rsc-dev/IAQ-MK2/iaq-mk2/src/ArduinoJson/README.md

# ArduinoJson (vendored)

Single-header release v7.4.3 of https://arduinojson.org (MIT, Benoit Blanchon),
unmodified. Vendored so the firmware and the host tests parse with the same
copy; no Library Manager dependency.
