rsc-dev/IAQ-MK2/docs/images/layouts/layout_A_current_bad.png

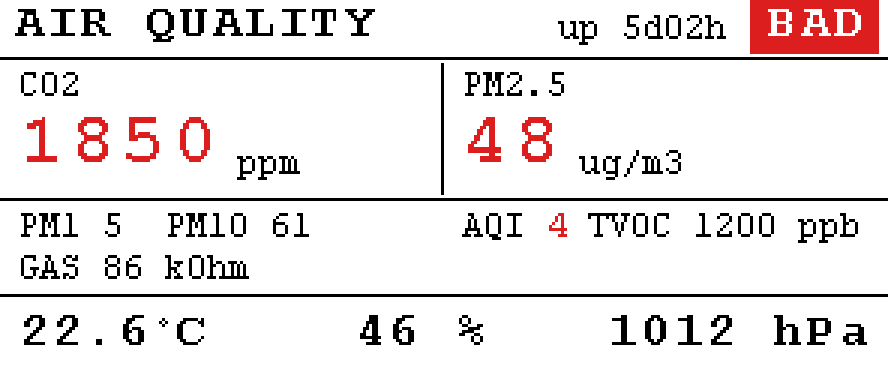
docs/images/layouts/layout_A_current_bad.png
