rsc-dev/IAQ-MK2/docs/images/layouts/layout_A_current_good.png

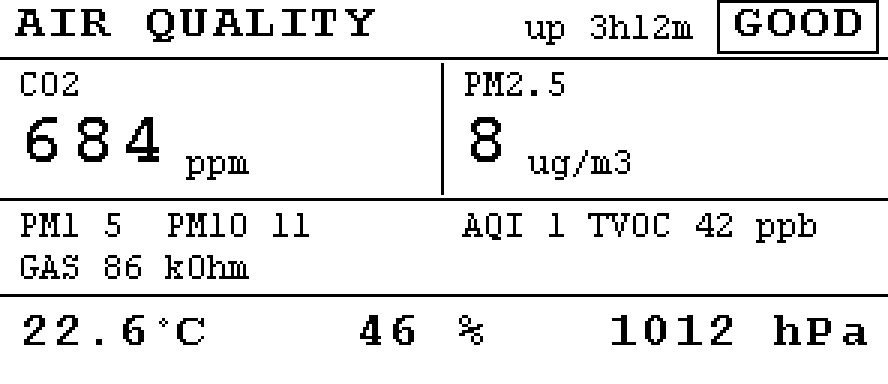
docs/images/layouts/layout_A_current_good.png
