rsc-dev/IAQ-MK2/docs/images/layouts/layout_B_three_tiles_good.png

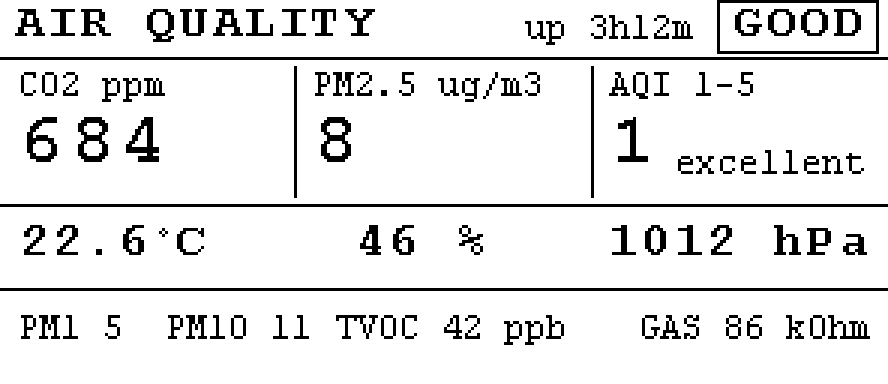
docs/images/layouts/layout_B_three_tiles_good.png
