rsc-dev/IAQ-MK2/docs/images/layouts/layout_C_status_board_bad.png

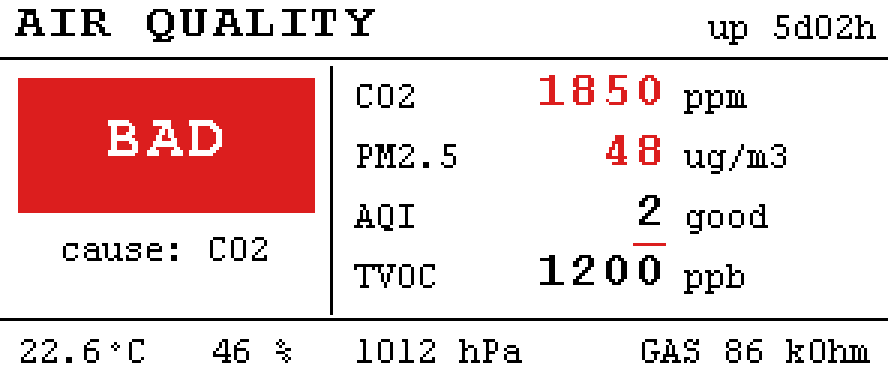
docs/images/layouts/layout_C_status_board_bad.png
