rsc-dev/IAQ-MK2/docs/images/layouts/layout_C_status_board_good.png

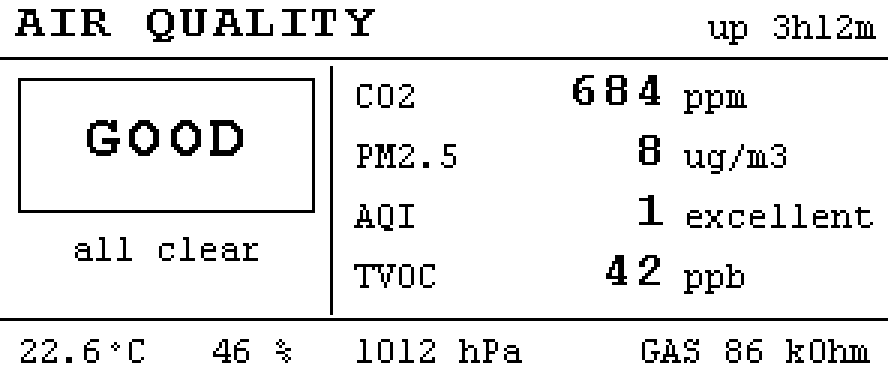
docs/images/layouts/layout_C_status_board_good.png
