rsc-dev/IAQ-MK2/docs/images/layouts/layout_D_climate_first_good.png

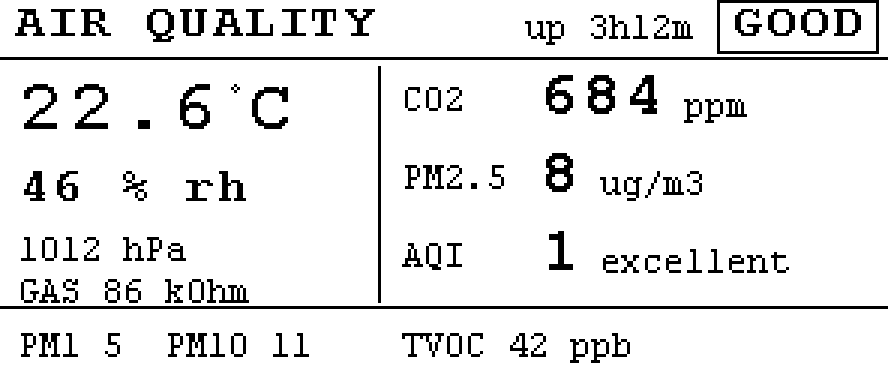
docs/images/layouts/layout_D_climate_first_good.png
