rsc-dev/IAQ-MK2/docs/images/layouts/layout_W1_outdoor_line_bad.png

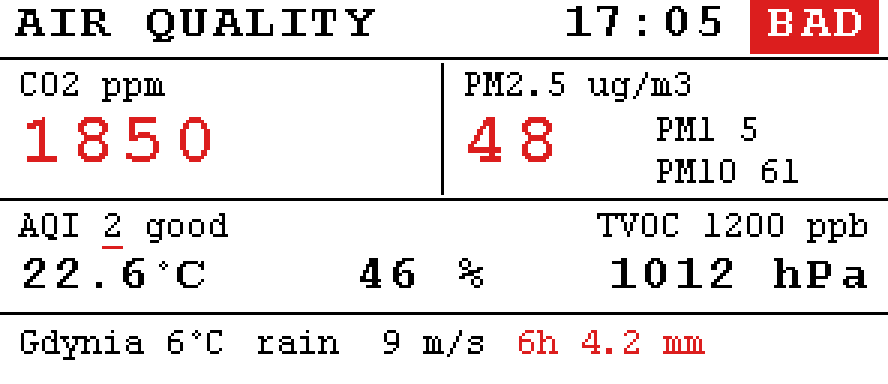
docs/images/layouts/layout_W1_outdoor_line_bad.png
