rsc-dev/IAQ-MK2/docs/images/layouts/layout_W2_outdoor_tile_good.png

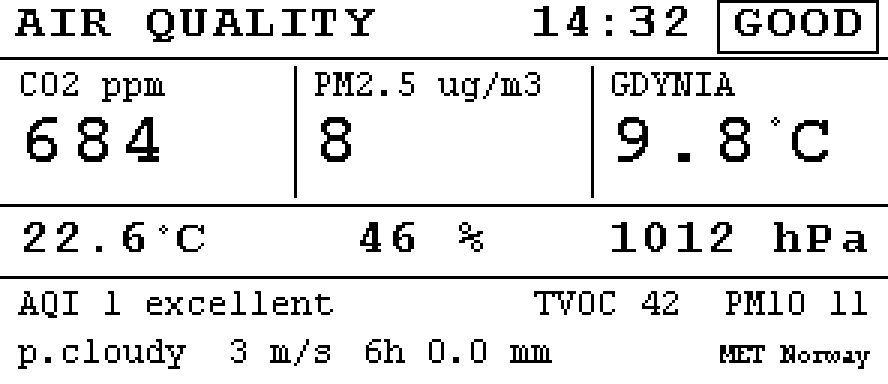
docs/images/layouts/layout_W2_outdoor_tile_good.png
