rsc-dev/IAQ-MK2/docs/images/layouts/layout_W2_outdoor_tile_offline.png

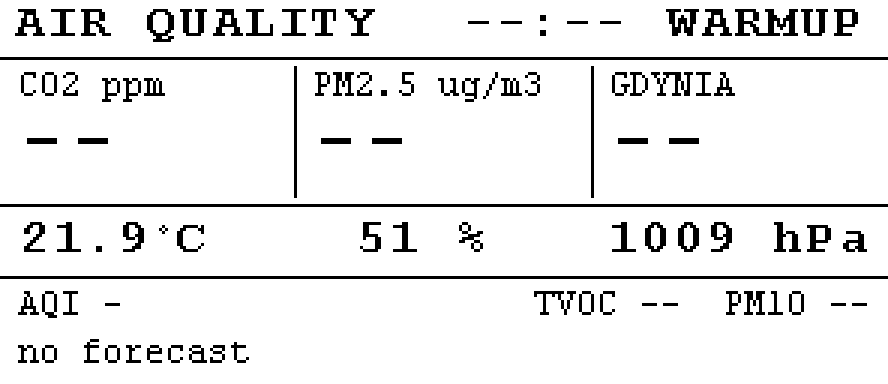
docs/images/layouts/layout_W2_outdoor_tile_offline.png
