rsc-dev/IAQ-MK2/iaq-mk2/src/waveshare/DEV_Config.cpp

// IAQ-MK2 replacement for Waveshare's DEV_Config.cpp targeting the Arduino
// Nano RP2040 Connect (mbed core): hardware SPI0 on D11/D13, control pins
// from config.h. The SSD1680 drives BUSY HIGH while busy, so BUSY gets a
// pull-down: a missing or dead panel reads "idle" and the refresh degrades to a
// logged "panel NOT busy" line instead of stalling every busy wait. The 2.9" (B)
// V4 module has eight wires and no PWR pin.
#include "DEV_Config.h"

#include "../../watchdog.h"

UBYTE DEV_Module_Init(void) {
  pinMode(EPD_BUSY_PIN, INPUT_PULLDOWN);
  pinMode(EPD_RST_PIN, OUTPUT);
  pinMode(EPD_DC_PIN, OUTPUT);
  pinMode(EPD_CS_PIN, OUTPUT);

  digitalWrite(EPD_CS_PIN, HIGH);
  digitalWrite(EPD_RST_PIN, HIGH);

  SPI.begin();
  SPI.beginTransaction(SPISettings(4000000, MSBFIRST, SPI_MODE0));
  return 0;
}

static int g_lastBusyLevel = -1;

void DEV_Busy_Trace(void) {
  const int level = digitalRead(EPD_BUSY_PIN);
  if (level == g_lastBusyLevel) return;
  g_lastBusyLevel = level;
  Serial.print("[epd] BUSY pin -> ");
  Serial.print(level ? "HIGH" : "LOW");
  Serial.print(" at ms=");
  Serial.println(millis());
}

void DEV_Delay_ms(uint32_t ms) {
  while (ms > 0) {
    const uint32_t step = ms > 5 ? 5 : ms;
    delay(step);
    ms -= step;
    watchdog::kick();
    DEV_Busy_Trace();
  }
}

void DEV_SPI_WriteByte(UBYTE data) { SPI.transfer(data); }

void DEV_SPI_Write_nByte(UBYTE *pData, UDOUBLE len) {
  for (UDOUBLE i = 0; i < len; i++) DEV_SPI_WriteByte(pData[i]);
}
