rsc-dev/IAQ-MK2/iaq-mk2/secrets.example.h

// WiFi credentials. Copy this file to secrets.h (git-ignored) and fill it in.
// secrets.h is never committed and never printed to the serial log.
#pragma once

#define SECRET_SSID "your-wifi-name"
#define SECRET_PASS "your-wifi-password"
