rsc-dev/IAQ-MK2/(commit log)

2026-10-06 feat: add printf-free fixed-point and uptime formatting
    [text_format.cpp, text_format.h]
2026-10-06 feat: add PMS7003 frame parser
2026-10-06 feat: add SEN0219 PWM to ppm conversion
2026-10-06 vendor: add Waveshare 2.9inch G driver with RP2040 DEV_Config and non-blocking patch
2026-10-06 feat: add SEN0219 interrupt capture and PMS7003 UART input
2026-10-06 docs: add README with wiring, build and bring-up checklist
2026-10-06 fix: keep the board flashable with the watchdog armed; add e-paper bring-up diagnostics
    Verified on hardware (Nano RP2040 Connect, all four sensors delivering data):
    - The bootrom's reset_usb_boot() arms the hardware watchdog with a ~10 ms
    countdown; our kicks cancelled it, so the 1200-baud upload reset never
    happened. The 1200-baud request is now handled by the sketch: suspend
    kicking, wait for the host to close the port, then enter the bootloader.
    - Longer boot delay so a terminal can catch the [boot] lines.
    - E-paper: BUSY polarity and software-SPI options, BUSY transition trace,
    init timing and busy-wait timeout counters in the log. The panel on the
    bench answers RST on BUSY bu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
    [DEV_Config.cpp, DEV_Config.h, config.h, epaper.cpp, epaper.h, iaq-mk2.ino, serial_log.cpp, serial_log.h]
2026-10-07 feat: drive the 2.9" (B) V4 panel (SSD1680) identified on the bench
    The module is the black/white/red 2.9" (B) V4, not the four-colour (G): it
    has eight wires and only answers the SSD1680 command set (16.4 s busy after
    master activation, visible refresh). Vendor the EPD_2in9b_V4 driver with the
    same non-blocking patch, split the 2-bpp dashboard into the two planes the
    controller takes, render WARN as black with red marks (no yellow available),
    drop the G-only options and the identification probe, update the docs.
    Verified on hardware: init 1.0 s, no busy-wait timeouts, full refresh done
    in 16.4 s, deep sleep afterwards.
2026-10-07 fix: review findings - BUSY pull-down for a missing panel, wrap-safe warm-up and uptime
    - SSD1680 drives BUSY HIGH while busy, so the old pull-up made a missing panel
    read busy forever and stall every vendor busy wait; use a pull-down and cut
    the vendor busy timeout to 3 s (bench: init 1.0 s, refresh 16.4 s unchanged).
    - Warm-up is latched and uptime counts millis() wraps (readiness.h), so a
    station past 49.7 days neither re-enters warm-up nor resets its uptime.
    Six new host tests cover the wrap.
    - Stale (G) mentions in comments fixed; README notes the blocked-USB-host case.
    [DEV_Config.cpp, co2_input.cpp, config.h, dashboard.h, iaq-mk2.ino, pm_input.cpp, readiness.cpp, readiness.h]
2026-10-07 feat: add live serial dump tool and ENS160 AQI notes
    tools/serial_dump.py (uv, Typer, pyserial) prints the summary lines as a
    table or raw, appends CSV, and reconnects across re-enumeration; parser
    tests via make -C tests tools. README explains the UBA AQI scale, why the
    ENS160 reports 3+ with clean CO2/PM, and the threshold knobs.
2026-10-07 feat: extract drawing primitives and add screen layout mockups
    draw.{h,cpp} holds the clipped primitives (unchanged output, README images
    byte-identical); tests/render_layouts.cpp renders three alternative layouts
    (three tiles, status board, climate first) in good and bad states via
    make -C tests layouts; PNGs under docs/images/layouts/.
2026-10-07 feat: HTTP body reader and MET Norway forecast extractor/parser (host-tested)
    ArduinoJson 7.4.3 vendored as a single header; Readings gains outdoor and
    time entries.
2026-10-07 feat: dashboard shows the chosen screen with clock and forecast line
    Units in the tile labels, PM1/PM10 inside the PM2.5 tile, AQI word, GAS off
    the panel, Europe/Warsaw clock in the header, Gdynia forecast line with the
    6 h rain figure in red from 0.5 mm. Host tests cover rain red, offline and
    stale forecast, outdoor extremes.
2026-10-07 feat: WiFi connection, NTP time and forecast fetch worker
    net: non-blocking connect with backoff, NTP epoch, NINA access mutex.
    weather: hourly HTTPS fetch in an mbed worker thread (TLS handshake and
    download never block loop() or the watchdog), result copied in update().
    Serial log gains wifi/rssi/time/wx_* keys; serial_dump shows them.
    Bench: WiFi connects in 1.6 s on NINA firmware 1.4.8, time syncs after
    ~60 s, panel refreshes unchanged; the TLS connect to api.met.no fails on
    this firmware (certificate bundle), see README.
    [config.h, iaq-mk2.ino, net.cpp, net.h, serial_dump.py, serial_log.cpp, weather.cpp]
2026-10-07 fix: review findings for the weather branch
    - Hung-worker guard: if a fetch is still busy after 90 s the NINA stopped
    answering; log and reboot (also resets the module). TLS connect bounded
    to 10 s.
    - First NTP read retried at every poll until it succeeds; WiFi attempts
    bail to backoff as soon as the module reports failure or no SSID.
    - Dropped-glyph counter in draw; the extreme/winter forecast lines are
    asserted to fit (the reported overflow did not reproduce).
    - Cached firmware string, unused fetchedEpoch removed, CSV columns for
    wind/rssi/counters, spec and README updated to the worker-thread design.
    Bench: NINA 3.0.1, WiFi connect ~2.6 s, forecast ok, time synced.
    Co-Authored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
    [config.h, draw.cpp, draw.h, forecast.cpp, forecast.h, net.cpp, net.h, readings.h]
2026-10-07 fix: do not treat transient WL_NO_SSID_AVAIL as a failed WiFi attempt
    The module reports it while scanning right after WiFi.begin(); only the
    30 s window decides. Bench: connects again in ~3 s.
    [net.cpp]
2026-10-07 build: firmware version constant and CI (host tests, firmware compile)
    IAQ_MK2_VERSION feeds the boot log and the MET Norway User-Agent. GitHub
    Actions runs the host and tool tests, renders the previews, and compiles
    the firmware with the pinned sketch.yaml profile and placeholder secrets,
    failing on warnings in project sources.
    [config.h, iaq-mk2.ino]
